astroelectronica/AE01.01.01.001/README.md

# AE01.01.01.001
ZXCT1080
Voltage output current monitor
