astroelectronica/AE01.01.01.001/pcb/AE01.01.01.001.png

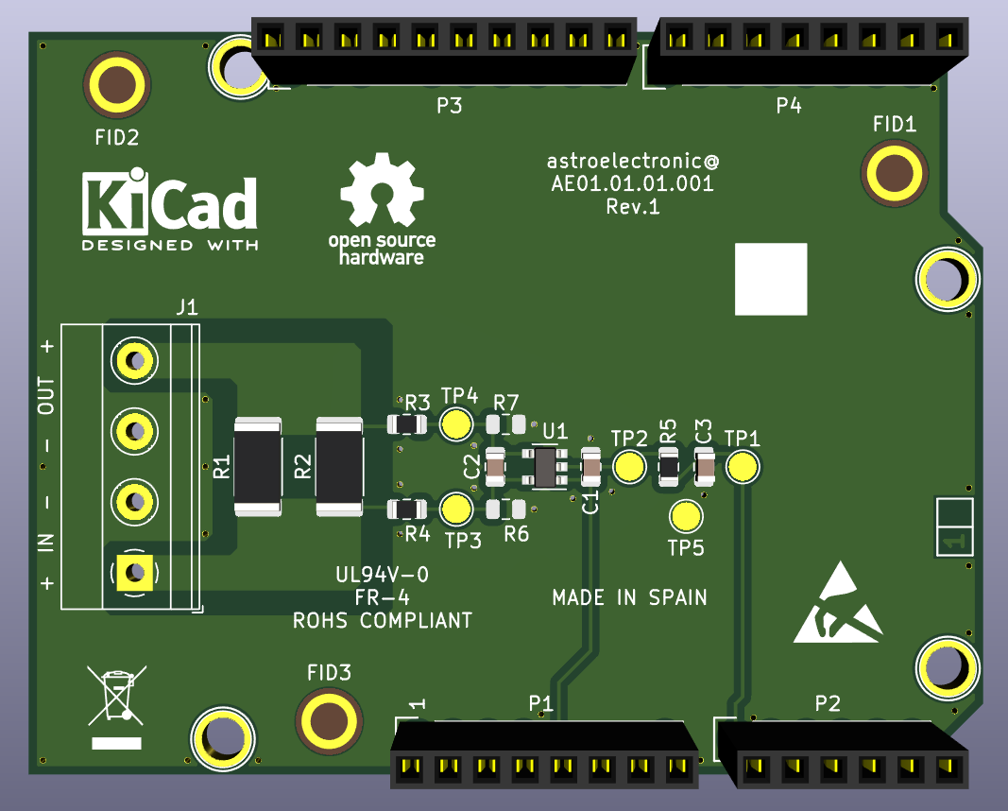
pcb/AE01.01.01.001.png
