astroelectronica/AE01.01.01.001/pcb/AE01.01.01.001.pdf

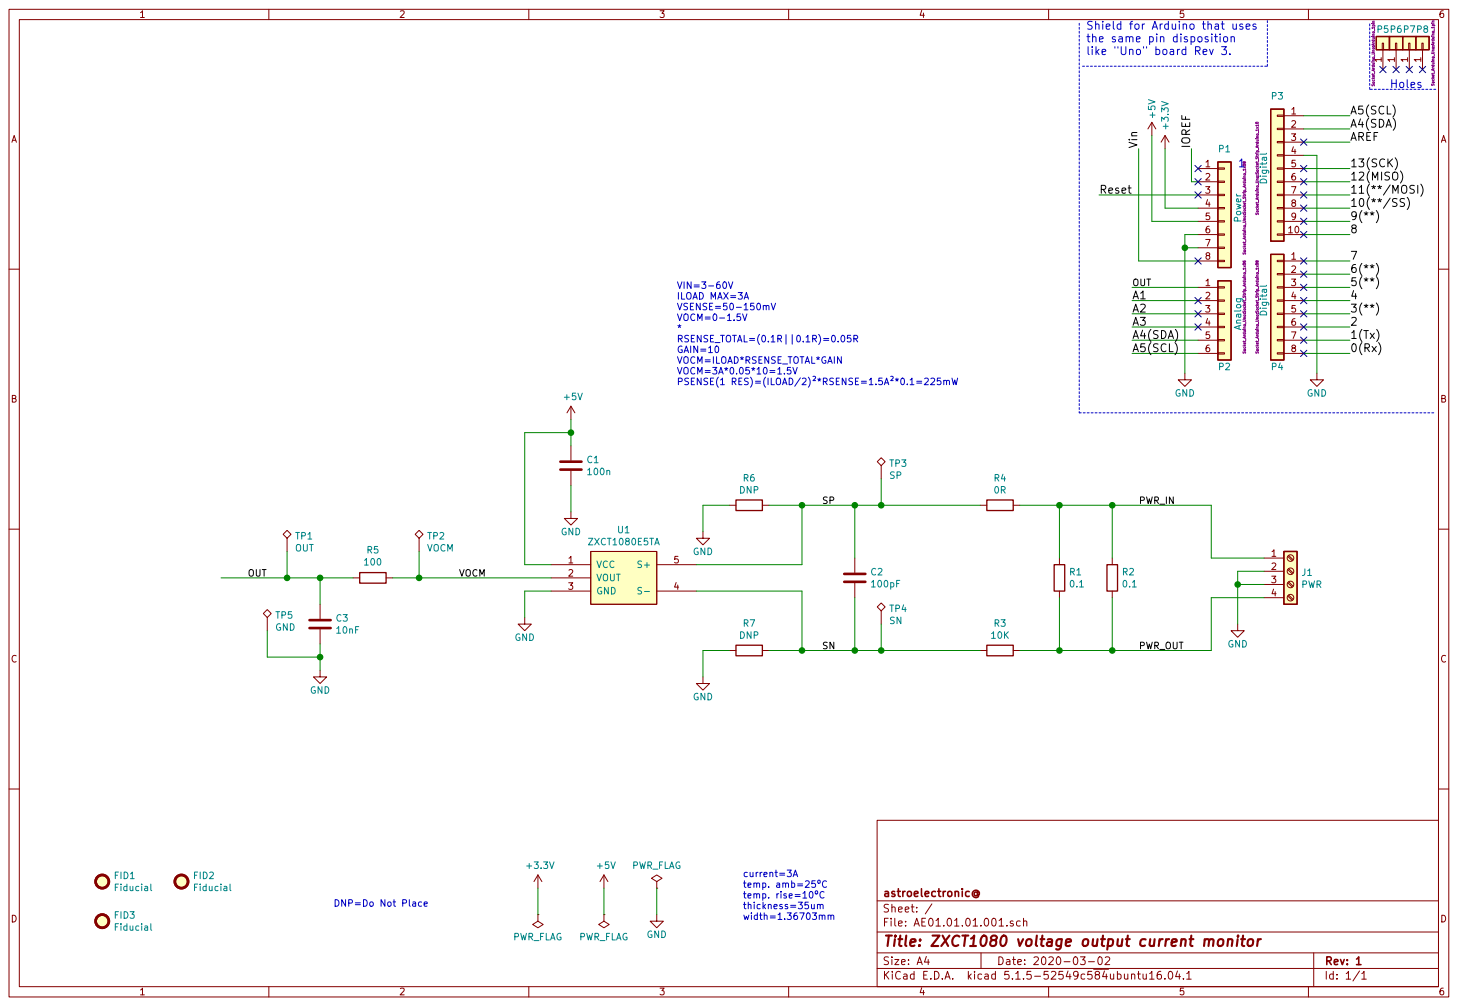
[picture p2: page 1]

Shield for Arduino that uses
the same pin disposition

ILOAD MAX=3A
VSENSE=50-150mV
VOCM=0-1.5V
*RSENSE_TOTAL=(0.1R||0.1R)=0.05R GAIN=10 VOCM=ILOAD*RSENSE_TOTAL*GAIN

VOCM=3A*0.05*10=1.5V
PSENSE(1 RES)=(ILOAD/2)²*RSENSE=1.5A²*0.1=225mW

Id: 1/1 Title: ZXCT1080 voltage output current monitor File: AE01.01.01.001.sch Sheet: / astroelectronic@

DNP=Do Not Place
