astroelectronica/AE01.01.01.001/pcb/output/AE01.01.01.001-B_Paste.pdf

Id: 1/1 Title: ZXCT1080 voltage output current monitor
