astroelectronica/AE01.01.01.001/pcb/output/AE01.01.01.001-Dwgs_User.pdf

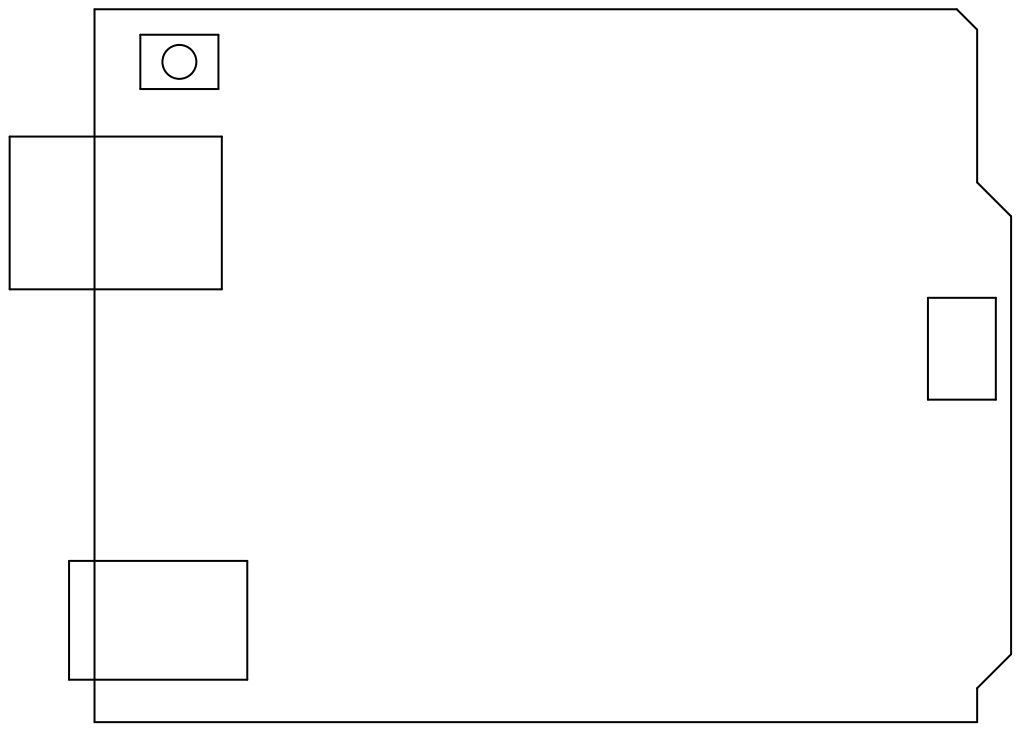
[picture p6: page 1]

Id: 1/1 Title: ZXCT1080 voltage output current monitor
