astroelectronica/AE01.01.01.001/pcb/output/AE01.01.01.001-F_Paste.pdf

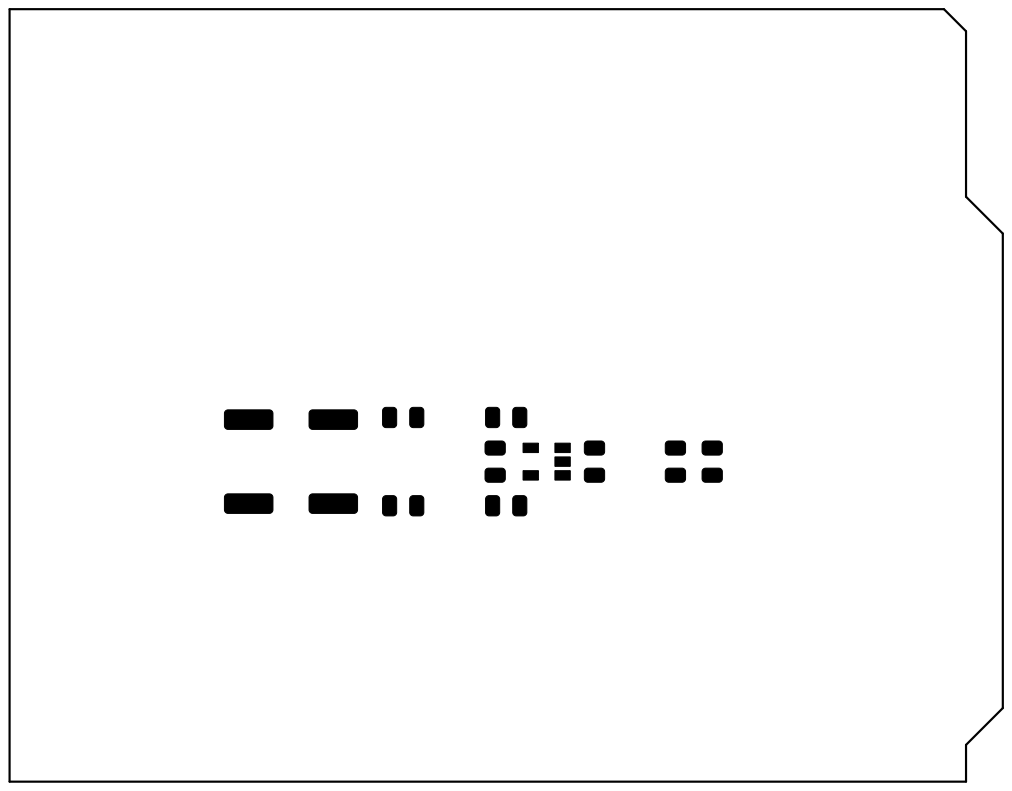
[picture p11: page 1]

Id: 1/1 Title: ZXCT1080 voltage output current monitor
