astroelectronica/AE01.01.01.001/simulation/sim01_load_regulation/AE01.01.01.001_sim01_load_regulation.pdf

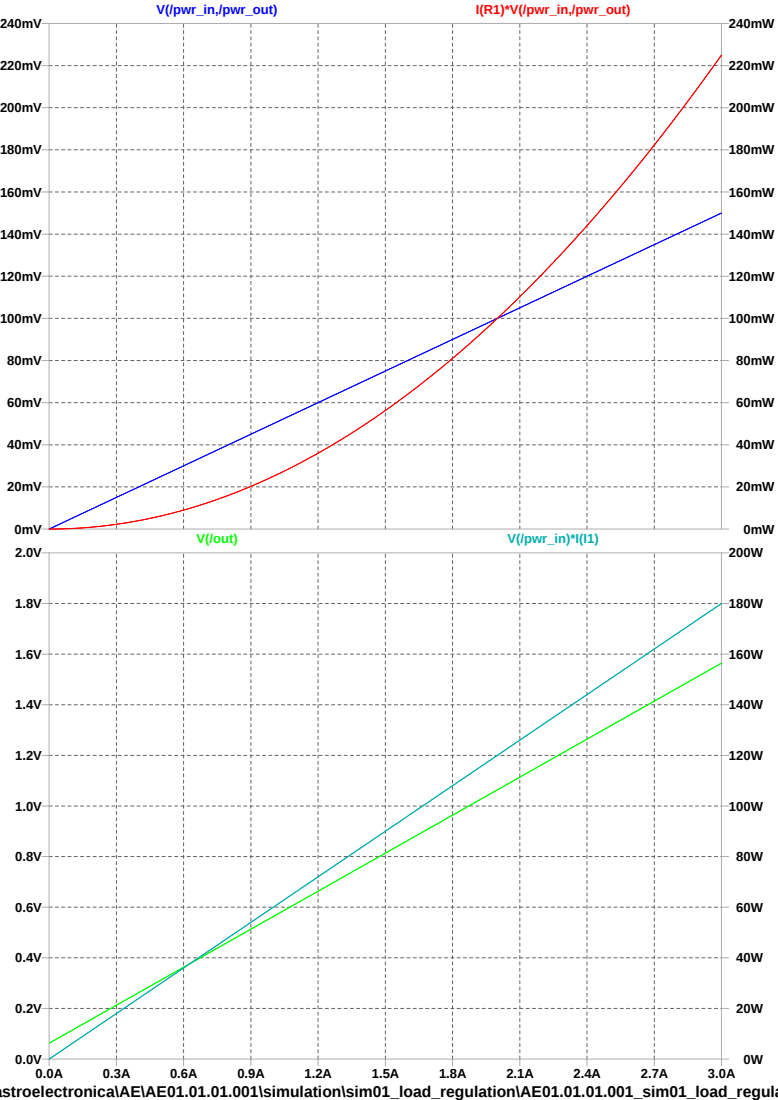
[picture p13: page 1]
V(/out); V(/pwr_in)*I(I1); V(/pwr_in,/pwr_out); I(R1)*V(/pwr_in,/pwr_out)

\astroelectronica\AE\AE01.01.01.001\simulation\sim01_load_regulation\AE01.01.01.001_sim01_load_regula
