astroelectronica/AE01.01.01.001/pcb/AE01.01.01.001.kicad_pcb

## KiCad design pcb/AE01.01.01.001.kicad_pcb (2021-07-02)

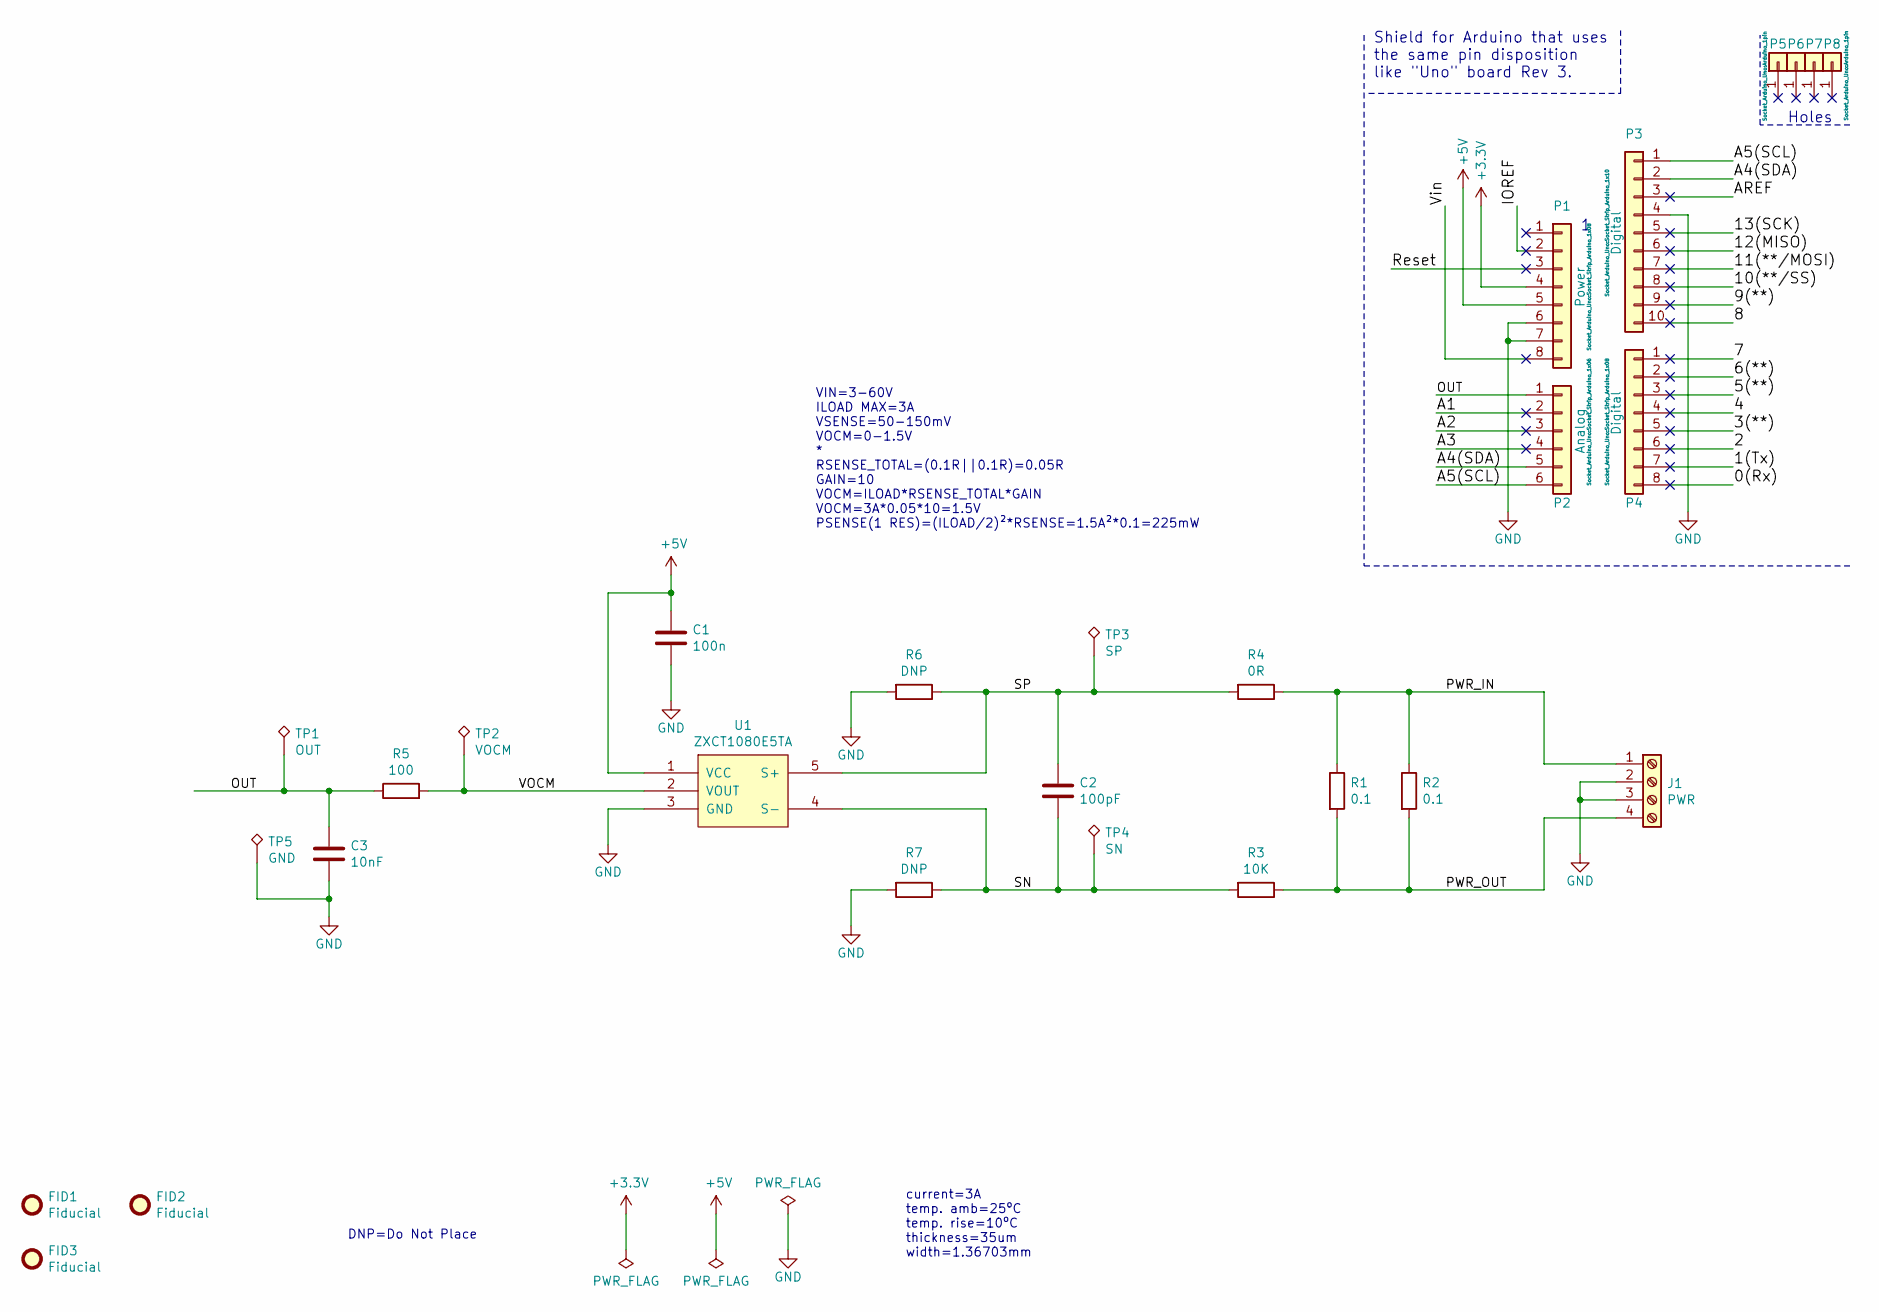
[picture p14: schematic AE01.01.01.001.sch, ZXCT1080 voltage output current monitor]

Parts:
C1: 100n; C_0805_2012Metric; MPN C2012X7R2A104K125AA
C2: 100pF; C_0805_2012Metric; MPN C2012CH2W101J060AA
C3: 10nF; C_0805_2012Metric; MPN C2012X7R2E103K125AA
FID1, FID2, FID3: Fiducial; Fiducial_Modern_CopperTop
J1: PWR; TerminalBlock_Phoenix_MKDS-1,5-4-5.08_1x04_P5.08mm_Horizont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; MPN 1715747
P1: Power; Socket_Strip_Arduino_1x08
P2: Analog; Socket_Strip_Arduino_1x06
P3: Digital; Socket_Strip_Arduino_1x10
P4: Digital; Socket_Strip_Arduino_1x08
P5, P6, P7, P8: CONN_01X01; Arduino_1pin
R1, R2: 0.1; R_2512_6332Metric; MPN CRA2512-FZ-R100ELF
R3: 10K; R_0805_2012Metric; MPN RC0805FR-0710KL
R4: 0R; R_0805_2012Metric; MPN RC0805JR-070RL
R5: 100; R_0805_2012Metric; MPN RC0805FR-07100RL
R6, R7: DNP; R_0805_2012Metric
TP1: OUT; TestPoint_Pad_D2.0mm
TP2: VOCM; TestPoint_Pad_D2.0mm
TP3: SP; TestPoint_Pad_D2.0mm
TP4: SN; TestPoint_Pad_D2.0mm
TP5: GND; TestPoint_Pad_D2.0mm
U1: ZXCT1080E5TA; SOT-23-5; MPN ZXCT1080E5TA

Connections:
+3V3: P1.4
+5V: C1.1, P1.5, U1.1 (VCC)
/0(Rx): P4.8
/1(Tx): P4.7
/2: P4.6
/3(**): P4.5
/4: P4.4
/5(**): P4.3
/6(**): P4.2
/7: P4.1
/8: P3.10
/9(**): P3.9
/10(**/SS): P3.8
/11(**/MOSI): P3.7
/12(MISO): P3.6
/13(SCK): P3.5
/A1: P2.2
/A2: P2.3
/A3: P2.4
/A4(SDA): P2.5, P3.2
/A5(SCL): P2.6, P3.1
/AREF: P3.3
/IOREF: P1.2
/OUT: C3.1, P2.1, R5.1, TP1.1
/PWR_IN: J1.1, R1.1, R2.1, R4.1
/PWR_OUT: J1.4, R1.2, R2.2, R3.1
/Reset: P1.3
/SN: C2.2, R3.2, R7.1, TP4.1, U1.4 (S-)
/SP: C2.1, R4.2, R6.1, TP3.1, U1.5 (S+)
/VOCM: R5.2, TP2.1, U1.2 (VOUT)
/Vin: P1.8
GND: C1.2, C3.2, J1.2, J1.3, P1.6, P1.7, P3.4, R6.2, R7.2, TP5.1, U1.3 (GND)

Notes on the sheet:
Holes
Shield for Arduino that uses the same pin disposition like "Uno" board Rev 3.
VIN=3-60V ILOAD MAX=3A VSENSE=50-150mV VOCM=0-1.5V * RSENSE_TOTAL=(0.1R||0.1R)=0.05R GAIN=10 VOCM=ILOAD*RSENSE_TOTAL*GAIN VOCM=3A*0.05*10=1.5V PSENSE(1 RES)=(ILOAD/2)²*RSENSE=1.5A²*0.1=225mW
current=3A temp. amb=25ºC temp. rise=10ºC thickness=35um width=1.36703mm
DNP=Do Not Place

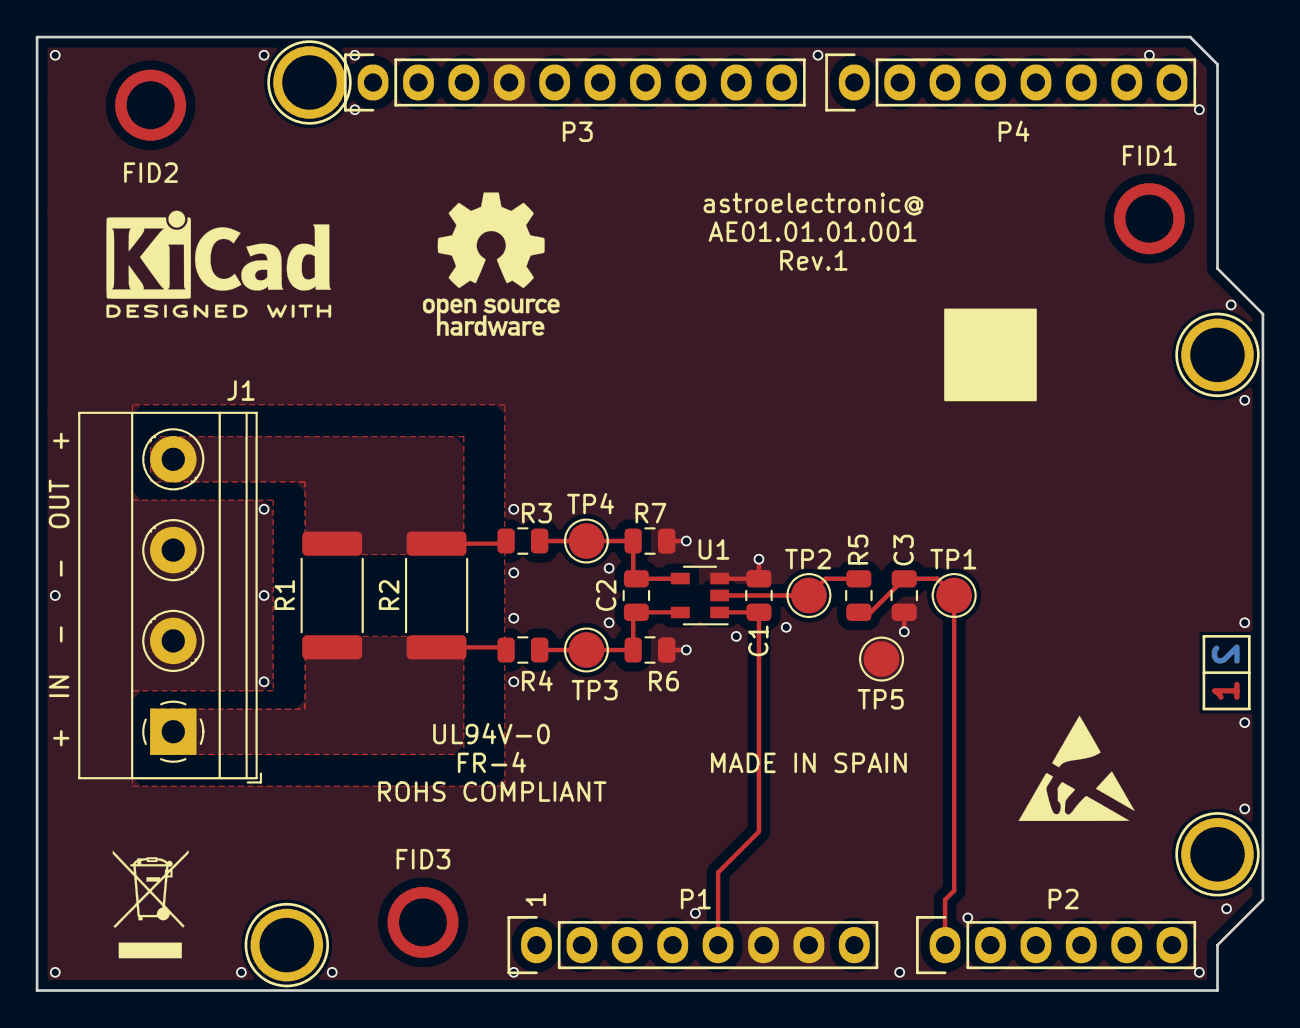
[picture p15: board AE01.01.01.001.kicad_pcb from above]

Board: 2 copper layers, 68.6 x 53.3 mm, 32 parts (0 on the bottom side), 10 nets.

Other parts of the board:
REF1: KiCad-Logo2_5mm_SilkScreen
REF2: OSHW-Logo_7.5x8mm_SilkScreen
REF3: ESD-Logo_6.6x6mm_SilkScreen
REF4: WEEE-Logo_4.2x6mm_SilkScreen
